RonHeg/PostAlertMailboxMFG/README.md

# PostAlertMailboxMFG
 PostAlert IoT Mailbox Unit Manufacturing documentation
