RonHeg/PostAlertMailboxMFG/Firmware Notes Mailbox.odt

Firmware Notes

RJ Hegler Technologies, LLC

Project: PostAlert Mailbox

Development Platform: STM32CubeIDE 1.15.1

Processor: STM32C011F6P

PC: Main

Path: C:\Users\Ron\STM32CubeIDE\workspace_1.15.1\STM32C0116_LoRa_Mailbox

Main.c:

/* USER CODE BEGIN Header */

/**

******************************************************************************

* @file : main.c

* @brief : Main program body

******************************************************************************

* @attention

*

* Portions (initialization) Copyright (c) 2024 STMicroelectronics.

* All rights reserved.

*

* This software is licensed under terms that can be found in the LICENSE file

* in the root directory of this software component.

* If no LICENSE file comes with this software, it is provided AS-IS.

*

* USER Code Copyright (c) 2024 RJ Hegler Technologies, LLC

******************************************************************************

*/

/* USER CODE END Header */

/* Includes ------------------------------------------------------------------*/

#include "main.h"

#include "adc.h"

#include "spi.h"

#include "gpio.h"

/* Private includes ----------------------------------------------------------*/

/* USER CODE BEGIN Includes */

#include "LoRa.h"

#include "string.h"

#include "stdio.h"

/* USER CODE END Includes */

/* Private typedef -----------------------------------------------------------*/

/* USER CODE BEGIN PTD */

/* USER CODE END PTD */

/* Private define ------------------------------------------------------------*/

/* USER CODE BEGIN PD */

/* USER CODE END PD */

/* Private macro -------------------------------------------------------------*/

/* USER CODE BEGIN PM */

/* USER CODE END PM */

/* Private variables ---------------------------------------------------------*/

/* USER CODE BEGIN PV */

LoRa myLoRa;

uint16_t LoRa_stat = 0;

uint8_t RxBuffer[20];

uint8_t txpacket[25];

char indata[18];

char TxBuffer[20];

char RxPacket[18];

char BatVolt[12];

uint32_t uid[3];

volatile int tiltBtnISR = 0;

volatile int pairBtnISR = 0;

// Magic numbers for 32-bit hashing. Copied from Murmur3.

static const uint32_t c1 = 0xcc9e2d51;

static const uint32_t c2 = 0x1b873593;

uint8_t mailBoxID[12];

char mbid[11];

uint32_t value_adc;

uint32_t batteryLevel;

char msg[4];

char cw[34] = "(c)2024 RJHegler Technologies, LLC";

char cx[5] = "V1.0";

/* USER CODE END PV */

/* Private function prototypes -----------------------------------------------*/

void SystemClock_Config(void);

/* USER CODE BEGIN PFP */

/* USER CODE END PFP */

/* Private user code ---------------------------------------------------------*/

/* USER CODE BEGIN 0 */

static uint32_t UNALIGNED_LOAD32(const char *p) {

uint32_t result;

memcpy(&result, p, sizeof(result));

return result;

}

static uint32_t Fetch32(const char *p) {

return UNALIGNED_LOAD32(p);

}

static uint32_t Rotate32(uint32_t val, int shift) {

// Avoid shifting by 32: doing so yields an undefined result.

return shift == 0 ? val : ((val >> shift) | (val << (32 - shift)));

}

// A 32-bit to 32-bit integer hash copied from Murmur3.

static uint32_t fmix(uint32_t h)

{

h ^= h >> 16;

h *= 0x85ebca6b;

h ^= h >> 13;

h *= 0xc2b2ae35;

h ^= h >> 16;

return h;

}

static uint32_t Mur(uint32_t a, uint32_t h) {

// Helper from Murmur3 for combining two 32-bit values.

a *= c1;

a = Rotate32(a, 17);

a *= c2;

h ^= a;

h = Rotate32(h, 19);

return h * 5 + 0xe6546b64;

}

// Generate UID value from uidstr[]

uint32_t Hash32Len5to12(const char *s, size_t len) {

uint32_t a = (uint32_t)len, b = a * 5, c = 9, d = b;

a += Fetch32(s);

b += Fetch32(s + len - 4);

c += Fetch32(s + ((len >> 1) & 4));

return fmix(Mur(c, Mur(b, Mur(a, d))));

}

uint32_t map(uint32_t au32_IN, uint32_t au32_INmin, uint32_t au32_INmax, uint32_t au32_OUTmin, uint32_t au32_OUTmax)

{

return ((((au32_IN - au32_INmin)*(au32_OUTmax - au32_OUTmin))/(au32_INmax - au32_INmin)) + au32_OUTmin);

}

void getBattery(void){

uint32_t voltage;

// get ADC value

HAL_ADC_Start(&hadc1);

HAL_ADC_PollForConversion(&hadc1, HAL_MAX_DELAY);

voltage = HAL_ADC_GetValue(&hadc1);

// sprintf(msg, "%lu", voltage);

// float volt = (voltage) * 0.00481;

// uint16_t volts = volt * 100;

// sprintf(msg, "%hu", volts);

if(voltage < 540){voltage = 540;}

if(voltage > 1034){voltage = 1034;}

batteryLevel = map(voltage, 540, 1034, 0, 100);

sprintf(msg, "%lu", batteryLevel);

}

/* USER CODE END 0 */

/**

* @brief The application entry point.

* @retval int

*/

int main(void)

{

/* USER CODE BEGIN 1 */

/* USER CODE END 1 */

/* MCU Configuration--------------------------------------------------------*/

/* Reset of all peripherals, Initializes the Flash interface and the Systick. */

HAL_Init();

/* USER CODE BEGIN Init */

/* USER CODE END Init */

/* Configure the system clock */

SystemClock_Config();

/* USER CODE BEGIN SysInit */

/* USER CODE END SysInit */

/* Initialize all configured peripherals */

MX_GPIO_Init();

MX_SPI1_Init();

MX_ADC1_Init();

/* USER CODE BEGIN 2 */

HAL_GPIO_WritePin (GPIOB, GPIO_PIN_7, GPIO_PIN_SET); //PWR_EN -> enable power supply

myLoRa = newLoRa();

myLoRa.CS_port = LORA_NSS_GPIO_Port;

myLoRa.CS_pin = LORA_NSS_Pin;

myLoRa.reset_port = RST_GPIO_Port;

myLoRa.reset_pin = RST_Pin;

myLoRa.DIO0_port = DIO0_GPIO_Port;

myLoRa.DIO0_pin = DIO0_Pin;

myLoRa.hSPIx = &hspi1;

myLoRa.frequency = 915; // default = 433 MHz

myLoRa.spredingFactor = SF_8; // default = SF_7

myLoRa.bandWidth = BW_125KHz; // default = BW_125KHz

myLoRa.crcRate = CR_4_5; // default = CR_4_5

myLoRa.power = POWER_11db; // default = 20db

myLoRa.overCurrentProtection = 100; // default = 100 mA

myLoRa.preamble = 8; // default = 8;

HAL_Delay(2000);

// SX1276 compatible module connected to SPI1, NSS pin connected to GPIO with label LORA_NSS

//uint8_t res = lora_init(&myLoRa, &hspi1, LORA_NSS_GPIO_Port, LORA_NSS_Pin, LORA_BASE_FREQUENCY_US);

if(LoRa_init(&myLoRa)==LORA_OK){

LoRa_stat = 1;

}

//Receiver side

LoRa_startReceiving(&myLoRa);

//uuid code:

char uidstr[25];

char uidstr1[7];

char uidstr2[9];

char uidstr3[9];

uint32_t uid;

// Arrange 12 bytes of UID into uidstr[]

uid = HAL_GetUIDw0();

sprintf(uidstr1, "%lu", uid);

// memcpy (&uidstr[8], &uid, 4);

uid = HAL_GetUIDw1();

sprintf(uidstr2, "%lu", uid);

// memcpy (&uidstr[4], &uid, 4);

uid = HAL_GetUIDw2();

sprintf(uidstr3, "%lu", uid);

strcpy(uidstr, uidstr1);

strcat(uidstr, uidstr2);

strcat(uidstr, uidstr3);

uid = Hash32Len5to12 ((const char *)uidstr, 25);

sprintf(mbid, "%lu", uid);

mbid[11] = 0;

// tiltBtnISR = 0; //clear isr

// pairBtnISR = 0; //clear isr

/* USER CODE END 2 */

/* Infinite loop */

/* USER CODE BEGIN WHILE */

while (1)

{

/* USER CODE END WHILE */

/* USER CODE BEGIN 3 */

HAL_Delay(500);

if(tiltBtnISR==1){

HAL_GPIO_WritePin (GPIOB, GPIO_PIN_7, GPIO_PIN_SET); //PWR_EN -> enable power supply

getBattery();

strcpy(TxBuffer, "md:");

strcat(TxBuffer, mbid);

strcat(TxBuffer, ":");

strcat(TxBuffer, msg);

memcpy(&txpacket, &TxBuffer, 20);

LoRa_transmit(&myLoRa, txpacket, sizeof(txpacket), 500);

// look for ak

LoRa_startReceiving(&myLoRa);

uint8_t ct = 0;

while (HAL_GPIO_ReadPin(GPIOA, DIO0_Pin) == 0 && ct < 10){

HAL_Delay(10);

ct++;

}

LoRa_receive(&myLoRa, RxBuffer, 20); //verify that ak received

//parse data: verify 'ak', skip ':' verify mbid match

uint8_t i=3;

uint8_t valid = 0;

if (RxBuffer[0] != 'a'){

valid = 1;

}

if (RxBuffer[1] != 'k'){

valid = 1;

}

while (RxBuffer[i] != ':'){

indata[i-3] = RxBuffer[i];

i++;

}

memcpy(&RxPacket, &RxBuffer, 18);

if (strcmp(indata, mbid) != 0){

valid = 1;

}

if(valid != 0){

HAL_Delay(100);

LoRa_transmit(&myLoRa, txpacket, sizeof(txpacket), 500); //retry

}

tiltBtnISR = 0; //clear isr

}

if(pairBtnISR==1){

HAL_GPIO_WritePin (GPIOB, GPIO_PIN_7, GPIO_PIN_SET); //PWR_EN -> enable power supply

strcpy(TxBuffer, "pr:");

strcat(TxBuffer, mbid);

strcat(TxBuffer, ":");

strcat(TxBuffer, "100");

memcpy(&txpacket, &TxBuffer, 20);

// HAL_UART_Transmit(&huart2, txpacket, 20, 1000);

LoRa_transmit(&myLoRa, txpacket, sizeof(txpacket), 500);

// LoRa_gotoMode(&myLoRa, SLEEP_MODE);

while(HAL_GPIO_ReadPin(GPIOA, PAIR_Pin) == 1){

HAL_Delay(50);

//***********************need button / door stuck added here

}

pairBtnISR = 0; //clear isr

}

/***************************************************************************

* keep power on for debugging -> remove commented out for release

*/

//************************need button / door stuck added here

HAL_Delay(50);

uint16_t ct = 0;

while (HAL_GPIO_ReadPin(GPIOA, TILT_Pin) == 1 && ct < 300){

HAL_Delay(100);

ct++;

}

if(HAL_GPIO_ReadPin(GPIOA, TILT_Pin) == 1){

//if (ct > 300){ //if door is open longer than 30 seconds

strcpy(TxBuffer, "do:");

strcat(TxBuffer, mbid);

strcat(TxBuffer, ":");

strcat(TxBuffer, msg);

memcpy(&txpacket, &TxBuffer, 20);

LoRa_transmit(&myLoRa, txpacket, sizeof(txpacket), 500);

}

tiltBtnISR = 0; //clear isr

// everything in deep sleep?

HAL_GPIO_WritePin (GPIOB, GPIO_PIN_7, GPIO_PIN_RESET); //PWR_EN -> disable power supply

}

/* USER CODE END 3 */

}

/**

* @brief System Clock Configuration

* @retval None

*/

void SystemClock_Config(void)

{

RCC_OscInitTypeDef RCC_OscInitStruct = {0};

RCC_ClkInitTypeDef RCC_ClkInitStruct = {0};

/** Initializes the RCC Oscillators according to the specified parameters

* in the RCC_OscInitTypeDef structure.

*/

RCC_OscInitStruct.OscillatorType = RCC_OSCILLATORTYPE_HSI;

RCC_OscInitStruct.HSIState = RCC_HSI_ON;

RCC_OscInitStruct.HSIDiv = RCC_HSI_DIV1;

RCC_OscInitStruct.HSICalibrationValue = RCC_HSICALIBRATION_DEFAULT;

if (HAL_RCC_OscConfig(&RCC_OscInitStruct) != HAL_OK)

{

Error_Handler();

}

/** Initializes the CPU, AHB and APB buses clocks

*/

RCC_ClkInitStruct.ClockType = RCC_CLOCKTYPE_HCLK|RCC_CLOCKTYPE_SYSCLK

|RCC_CLOCKTYPE_PCLK1;

RCC_ClkInitStruct.SYSCLKSource = RCC_SYSCLKSOURCE_HSI;

RCC_ClkInitStruct.SYSCLKDivider = RCC_SYSCLK_DIV1;

RCC_ClkInitStruct.AHBCLKDivider = RCC_HCLK_DIV1;

RCC_ClkInitStruct.APB1CLKDivider = RCC_APB1_DIV2;

if (HAL_RCC_ClockConfig(&RCC_ClkInitStruct, FLASH_LATENCY_1) != HAL_OK)

{

Error_Handler();

}

}

/* USER CODE BEGIN 4 */

// interrupt entry:

//Receiver side

void HAL_GPIO_EXTI_Falling_Callback(uint16_t GPIO_Pin){

// is irq from tilt sensor?

if(GPIO_Pin == TILT_Pin){

tiltBtnISR = 1;

}

//is irq from pair button?

if(GPIO_Pin == PAIR_Pin){

pairBtnISR = 1;

}else {

//tiltBtnISR = 0;

//pairBtnISR = 0;

__NOP();

}

}

/* USER CODE END 4 */

/**

* @brief This function is executed in case of error occurrence.

* @retval None

*/

void Error_Handler(void)

{

/* USER CODE BEGIN Error_Handler_Debug */

/* User can add his own implementation to report the HAL error return state */

__disable_irq();

while (1)

{

HAL_GPIO_WritePin (GPIOB, GPIO_PIN_7, GPIO_PIN_RESET); //PWR_EN -> disable power supply

}

/* USER CODE END Error_Handler_Debug */

}

#ifdef USE_FULL_ASSERT

/**

* @brief Reports the name of the source file and the source line number

* where the assert_param error has occurred.

* @param file: pointer to the source file name

* @param line: assert_param error line source number

* @retval None

*/

void assert_failed(uint8_t *file, uint32_t line)

{

/* USER CODE BEGIN 6 */

/* User can add his own implementation to report the file name and line number,

ex: printf("Wrong parameters value: file %s on line %d\r\n", file, line) */

/* USER CODE END 6 */

}

#endif /* USE_FULL_ASSERT */
