RonHeg/PostAlertMailboxMFG/042024MailBox Label.pdf

### PostAlert IoT Mail Box Label Drawing Number: 042024-LBL Revision 1.0

### RJ Hegler Technologies, LLC 9192 Albion Road North Royalton, Ohio 44133 RJHeglerTech@gmail.com Ron Hegler

440-478-1586

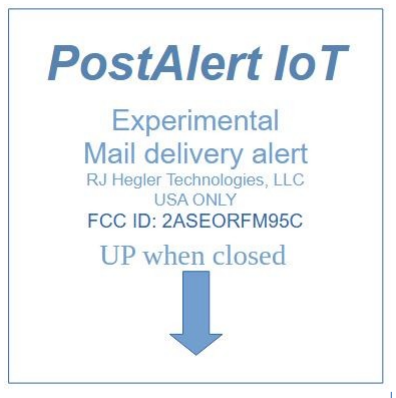
[picture p1: figure]

Overlay attaches to top of :
Hammond Manufacturing 1593JBK Enclosure

Notes:
Material: Glossy 0.2mm, PET

Adhesive backing: 3M468MP

Colors
Aqua = Pantone 319 C (RGB 44, 204, 211 – HEX 2cccd3) Black = Pantone 6C(RGB 16, 24, 32 – HEX 101803)
Gray = Pantone 5315 C (RGB 216, 215, 223 – HEX d8d7df)

Suggested Supplier:
LCSC Electronics (https://www.lcsc.com/)

# Note: Reference Drawing for

cost quoting only.

# Actual drawing will be created

when FCC ID is assigned.

2.15”

2.15”
