RonHeg/PostAlertMailboxMFG/PostAlertMailBoxV6_1.xls

Sheet: PostAlertMailBoxV6
Source: | C:\RJHTech\Mailbox\PostAlertBaseStation\PostAlertMailBoxV6\PostAlertMailBoxV6.kicad_sch
Date: | 12/10/2024 10:33:40 AM
Tool: | Eeschema 7.0.10
Generator: | C:\Program Files\KiCad\7.0\bin\scripting\plugins/bom_csv_grouped_by_value.py
Component Count: | 41
Collated Components:
Item | Qty | Reference(s) | Value | Datasheet | Description | MFR | PN | Price(100s) | Supplier | Supplier_num
1 | 1 | AE1 | Antenna | https://www.ti.com/lit/an/swra416/swra416.pdf?ts=1721033543556
2 | 1 | C1 | DNP | https://www.vishay.com/docs/45199/vjcommercialseries.pdf | Multilayer Ceramic Capacitors MLCC - SMD/SMT 0603 82pF 100volts C0G 5% | Vishay / Vitramon | VJ0603A820JXBAC | 0.073 | Mouser | 77-VJ0603A820JXBAC
3 | 1 | C2 | 3.3pF | https://www.mouser.com/datasheet/2/40/C0GNP0_Dielectric-2952720.pdf | Multilayer Ceramic Capacitors MLCC - SMD/SMT 25V 3.3pF 10% | Kyocera AVX | 06033A3R3KAT2A | 0.073 | Mouser | 581-06033A3R3KAT2A
4 | 3 | C3, C8, C13 | 1uF, 16v | https://www.mouser.com/ProductDetail/TAIYO-YUDEN/MSASE168SB7105KTNA01?qs=tlsG%2FOw5FFh5ATmmYVDecQ%3D%3D | MLCC - SMD/SMT 16V 1uF X7R 0603 10 % | TAIYO YUDEN | MSASE168SB7105KTNA01 | 0.023 | Mouser | 963-MSASE168SB7105KT
5 | 4 | C4, C6, C9, C11 | 10uf 6.3v | https://www.mouser.com/ProductDetail/KYOCERA-AVX/KGM15CR50J106MT?qs=Jm2GQyTW%2Fbif%2Fz3WIqU0uQ%3D%3D | 6.3V 10uF X5R 0603 20% | KYOCERA AVX | KGM15CR50J106MT | 0.061 | Mouser | 581-06036D106MAT2A
6 | 3 | C5, C7, C10 | 0.1uF | https://www.mouser.com/ProductDetail/KYOCERA-AVX/KGM15BR71H104KT?qs=Jm2GQyTW%2FbhrbR7gNqPCtw%3D%3D | 50V .1uF X7R 0603 10% | KYOCERA AVX | KGM15BR71H104KT | 0.019 | Mouser | A581-06035C104KAT2A
7 | 4 | D1, D2, D3, D4 | 1N4148W | https://www.digikey.in/en/htmldatasheets/production/1227459/0/0/1/1n4148w | DIODE GEN PURP 75V 0.15A SOD123F | Diotec Semiconductor | 1N4148W | 0.0378 | Digikey | 4878-1N4148WCT-ND
8 | 1 | J1 | Prog | ~ | CONN HEADER VERT 5POS 2.54MM | Harwin Inc. | M20-9990546 | 0.1707 | Digikey | 952-2268-ND
9 | 2 | J2, J3 | BATT CLIP | https://www.keyelco.com/userAssets/file/M65p11.pdf | BATT CONT CLIP A/AA 1 CEL PC PIN | Keystone Electronics | 92 | 0.2657 | Digikey | 36-92-ND
10 | 1 | L1 | 14nH | 14nH | RF Inductors - SMD Chip Wire Ind 1608(0603) 14nH +/-2% | Walsin | WLCW1608Z0G14NPB | 0.085 | Mouser
11 | 1 | Q1 | MMBT3904 | https://www.onsemi.com/pdf/datasheet/pzt3904-d.pdf | TRANS NPN 40V 0.2A SOT23 | Micro Commercial Co | MMBT3904-TP | 0.0369 | Digikey | MMBT3904TPMSCT-ND
12 | 1 | R1 | 220k | https://www.mouser.com/datasheet/2/54/CRT-1649066.pdf | Thin Film Resistors - SMD CHIP RESISTOR Precision | Vishay / Dale | CRCW0603220KFKEA | 0.01 | Mouser | 71-CRCW0603-220K-E3
13 | 3 | R2, R6, R8 | 10k | https://www.mouser.com/datasheet/2/54/CRT-1649066.pdf | Thin Film Resistors - SMD CHIP RESISTOR Precision | Vishay / Dale | CRCW060310K0FKEAC | 0.01 | Mouser | 71-CRCW060310K0FKEAC
14 | 3 | R3, R4, R7 | 100k | https://www.mouser.com/datasheet/2/54/CRT-1649066.pdf | Thin Film Resistors - SMD CHIP RESISTOR Precision | Vishay / Dale | CRCW0603100KFKEE | 0.013 | Mouser | 71-CRCW0603100KFKEE
15 | 1 | SW1 | TILT | C:\RJHTech\Mailbox\Components\SW-520-BAILIN.pdf | SW-520 Roll Ball Switch | BAILIN ELECTRONICS CO.,LTD | SW-520D | 0.3591 | Amazon | SW-520D
16 | 1 | SW2 | SW_Push | https://www.mouser.com/datasheet/2/670/ts04-2586192.pdf | Tactile Switches 6 x 6 mm 7.3 mm 160 gf Black Right Angle Through Hole SPST | CUI Devices | TS04-66-73-BK-100-SMT | 0.099 | Mouser | 179-TS046673BK100SMT
23 | 1 | U1 | MAX40203AUK+T | https://datasheets.maximintegrated.com/en/ds/MAX40200.pdf | Low Current Ideal Diode | Analog Devices | MAX40203AUK+T | 0.679 | Mouser | 700-MAX40203AUK+T
24 | 1 | U2 | RFM95CW | https://www.hoperf.com/modules/lora/RFM95CW.html#apDocument | RF TXRX MODULE ISM<1GHZ WIRE ANT | Hope FR | COM-18085 | 9.95 | Sparkfun | RFM95C
25 | 1 | U3 | STM32C011F6Px | https://www.st.com/resource/en/datasheet/stm32c011f6.pdf | rm Cortex-M0+ MCU 32 Kbytes Flash 6 Kbytes RAM 48 MHz CPU 2x USART | STMicroelectronics | STM32C011F6P6 | 0.778 | Mouser | 511-STM32C011F6P6
26 | 1 | U4 | XC6210B332MR | https://www.torexsemi.com/file/xc6210/XC6210.pdf | IC REG LINEAR 3.3V 700MA SOT25 | Torex Semiconductor Ltd | XC6210B332MR-G | 0.5443 | Digikey | 893-1075-1-ND

Sheet: Mechanical
Reference | Value | Description | MFR | PN | Price(100s) | Supplier | Supplier_num | Qty | Inventory | On Order | Datasheet
 |  | Battery
 |  | Box, 2.61x2.61 | Hammond | 1593JBK | 2.45 | Mouser |  | 1 | 1 |  | https://www.mouser.com/datasheet/2/177/1593-1389796.pdf

Sheet: PostAlertMailBoxV6_2Supplier
Reference(s) | Value | Description | MFR | PN | Qty
AE1 | Antenna | PCB Etch
C1 | DNP | MLCC - SMD/SMT 0603 82pF 100volts C0G 5% | Vishay / Vitramon | VJ0603A820JXBAC | 0
C2 | 3.3pF | Multilayer Ceramic Capacitors MLCC - SMD/SMT 25V 3.3pF 10% | Kyocera AVX | 06033A3R3KAT2A | 1
C3, C8, C13 | 1uF, 16v | MLCC - SMD/SMT 16V 1uF X7R 0603 10 % | TAIYO YUDEN | MSASE168SB7105KTNA01 | 3
C4, C6, C9, C11 | 10uf 6.3v | 6.3V 10uF X5R 0603 20% | KYOCERA AVX | KGM15CR50J106MT | 4
C5, C7, C10 | 0.1uF | 50V .1uF X7R 0603 10% | KYOCERA AVX | KGM15BR71H104KT | 3
D1, D2, D3, D4 | 1N4148W | DIODE GEN PURP 75V 0.15A SOD123F | Diotec Semiconductor | 1N4148W | 4
J1 | Prog | CONN HEADER VERT 5POS 2.54MM | Harwin Inc. | M20-9990546 | 1
J2, J3 | BATT CLIP | BATT CONT CLIP A/AA 1 CEL PC PIN | Keystone Electronics | 92 | 2
L1 | 14nH | RF Inductors - SMD Chip Wire Ind 1608(0603) 14nH +/-2% | Walsin | WLCW1608Z0G14NPB | 1
Q1 | MMBT3904 | TRANS NPN 40V 0.2A SOT23 | Micro Commercial Co | MMBT3904-TP | 1
R1 | 220k | Thin Film Resistors - SMD CHIP RESISTOR Precision | Vishay / Dale | CRCW0603220KFKEA | 1
R2, R6, R8 | 10k | Resistor 0603 10k | Vishay / Dale | CRCW060310K0FKEAC | 3
R3, R4, R7 | 100k | Resistor 0603 100k | Vishay / Dale | CRCW0603100KFKEAC | 3
SW1 | TILT | SW-520 Roll Ball Switch | BAILIN ELECTRONICS | SW-520D | 1
SW2 | SW_Push | Tactile Switches 6 x 6 mm 7.3 mm 160 gf SPST SMT | CUI Devices | TS04-66-73-BK-100-SMT | 1
U1 | MAX40203AUK+T | Low Current Ideal Diode | Analog Devices | MAX40203AUK+T
U2 | RFM95CW | RF TXRX MODULE ISM<1GHZ WIRE ANT | Hope FR | COM-18085 | 1
U3 | STM32C011F6Px | Cortex-M0+ MCU 32 K Flash 6 K RAM 48 MHz | STMicroelectronics | STM32C011F6P6 | 1
U4 | XC6210B332MR | IC REG LINEAR 3.3V 700MA SOT25 | Torex Semiconductor Ltd | XC6210B332MR-G | 1
 | Battery | Battery, Li 3.6v, AA Primary | Rammway | ER14505 | 1
 | Enclosure | Box, 2.61x2.61 | Hammond | 1593JBK | 1
