RonHeg/PostAlertMailboxMFG/(list of files, cad)

Other CAD files:
042024ASSY.dxf
