RonHeg/PostAlertMailboxMFG/042024ASSY.pdf

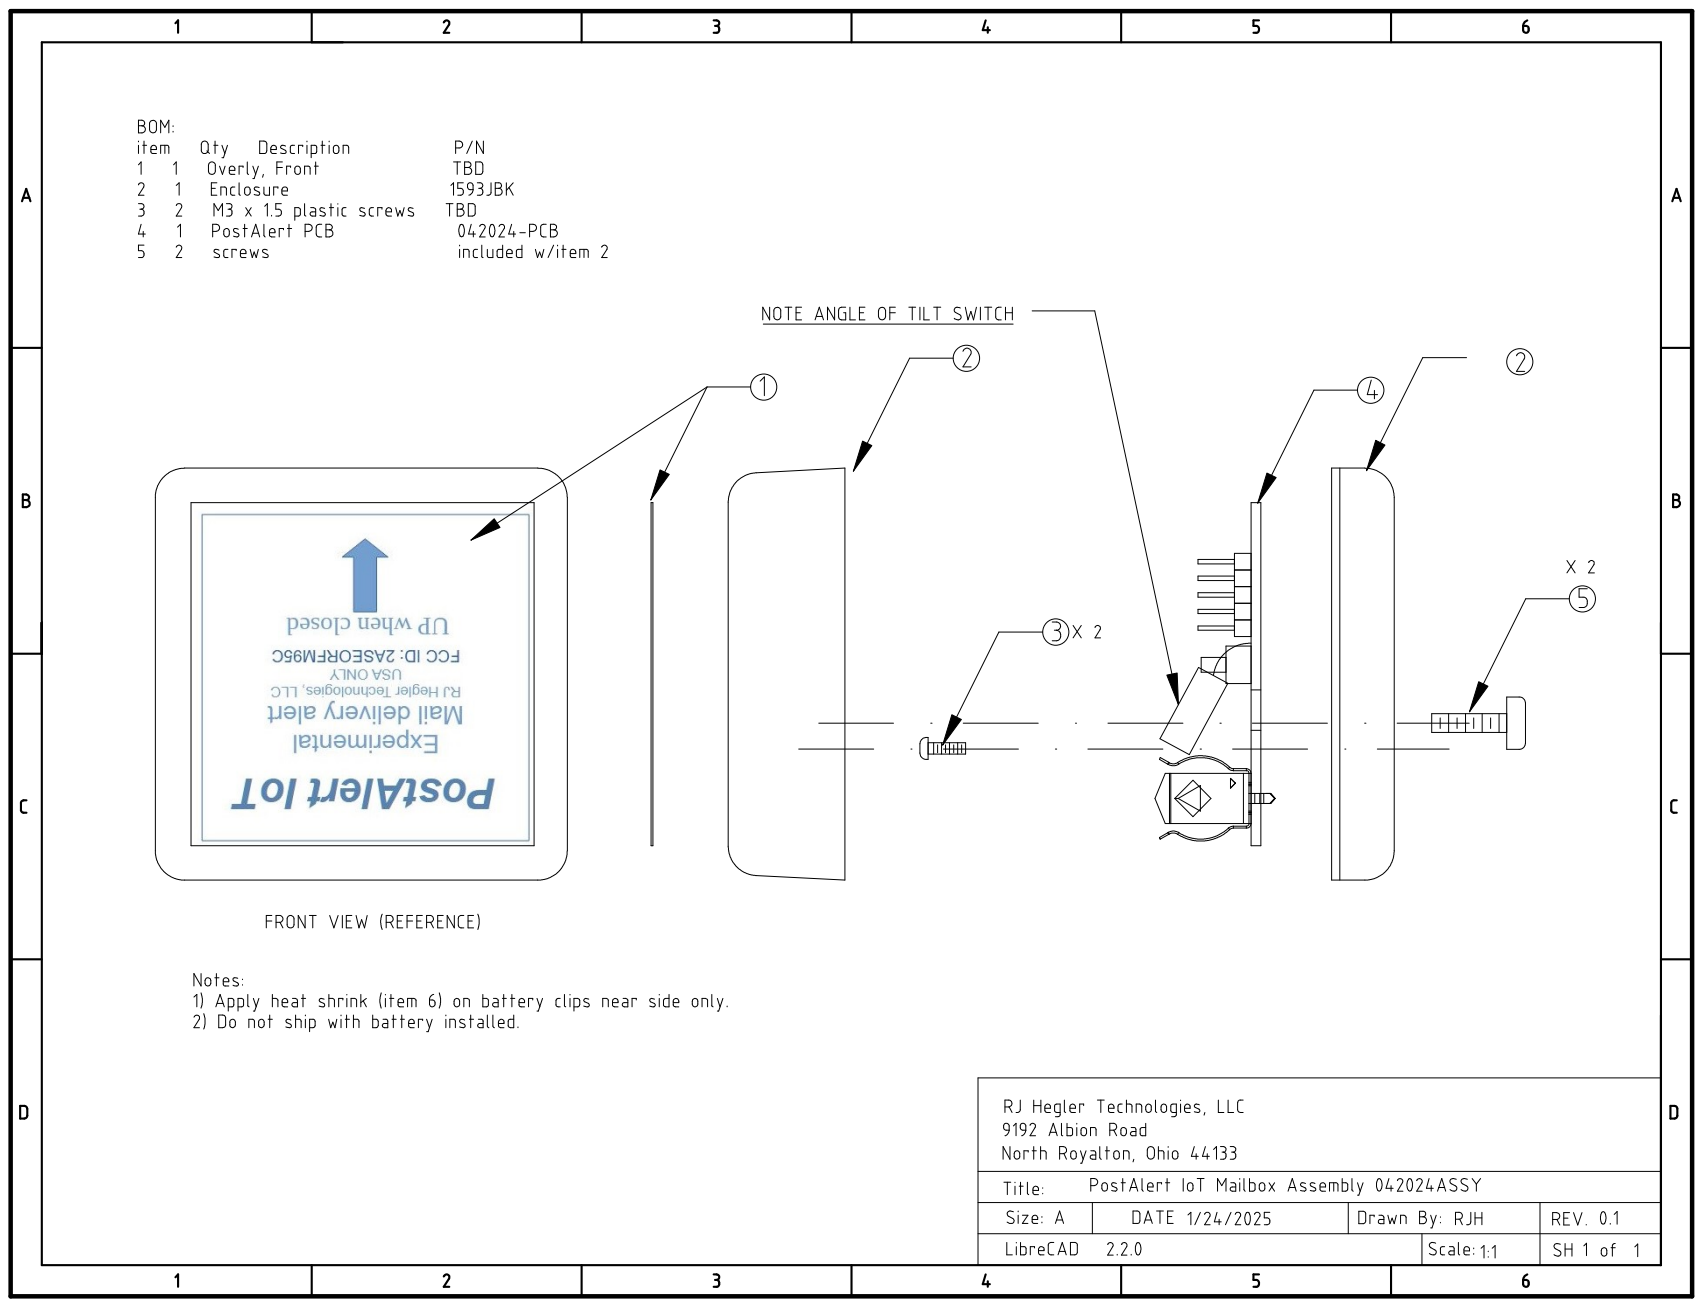
[picture p2: page 1]
