RonHeg/PostAlertMailboxMFG/PostAlert_Mailbox_PCB_Fab_Dwg.pdf

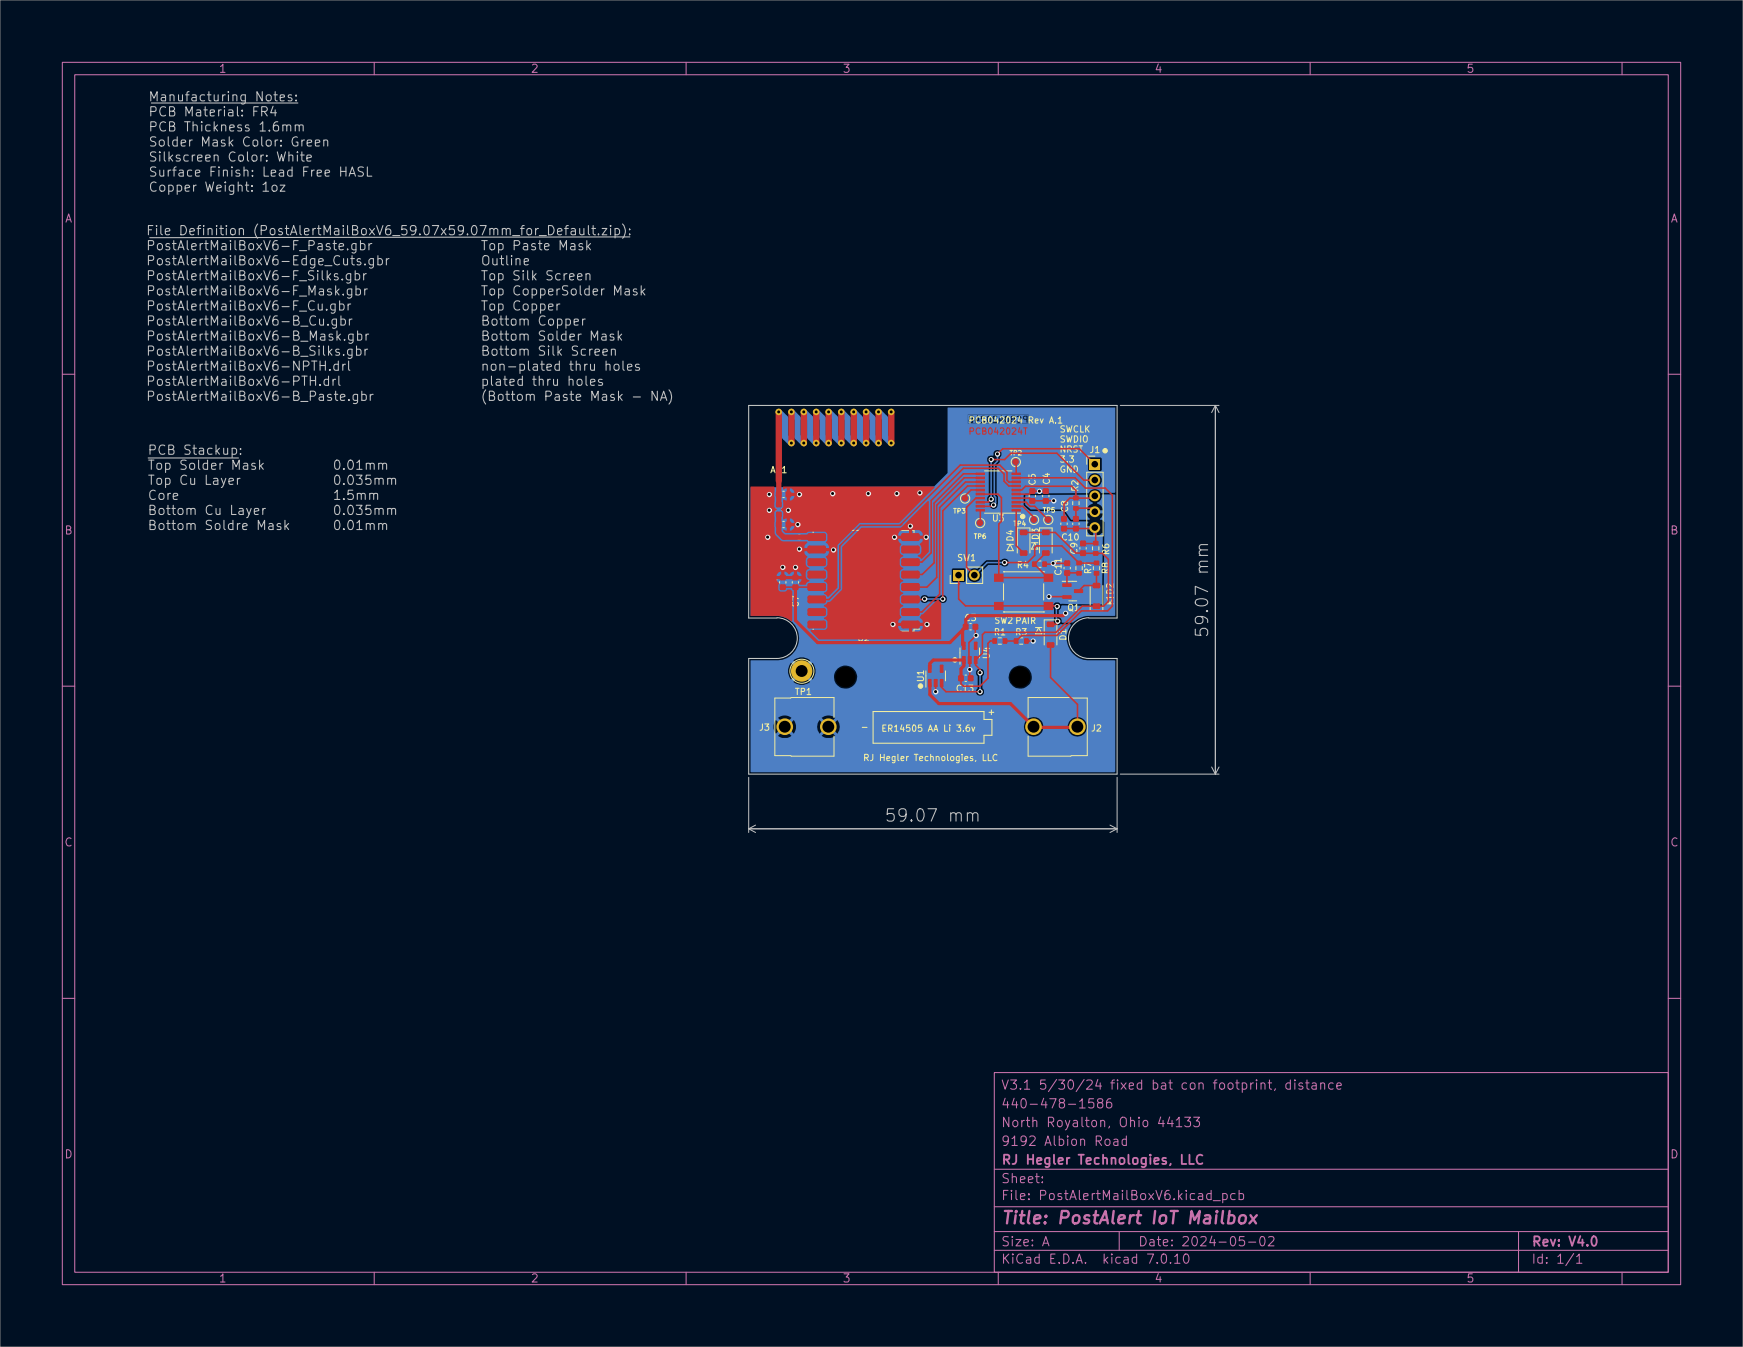
[picture p3: page 1]
