RonHeg/PostAlertMailboxMFG/KiCad/PostAlertMailBoxV6.kicad_pcb

## KiCad design KiCad/PostAlertMailBoxV6.kicad_pcb (2025-02-27)

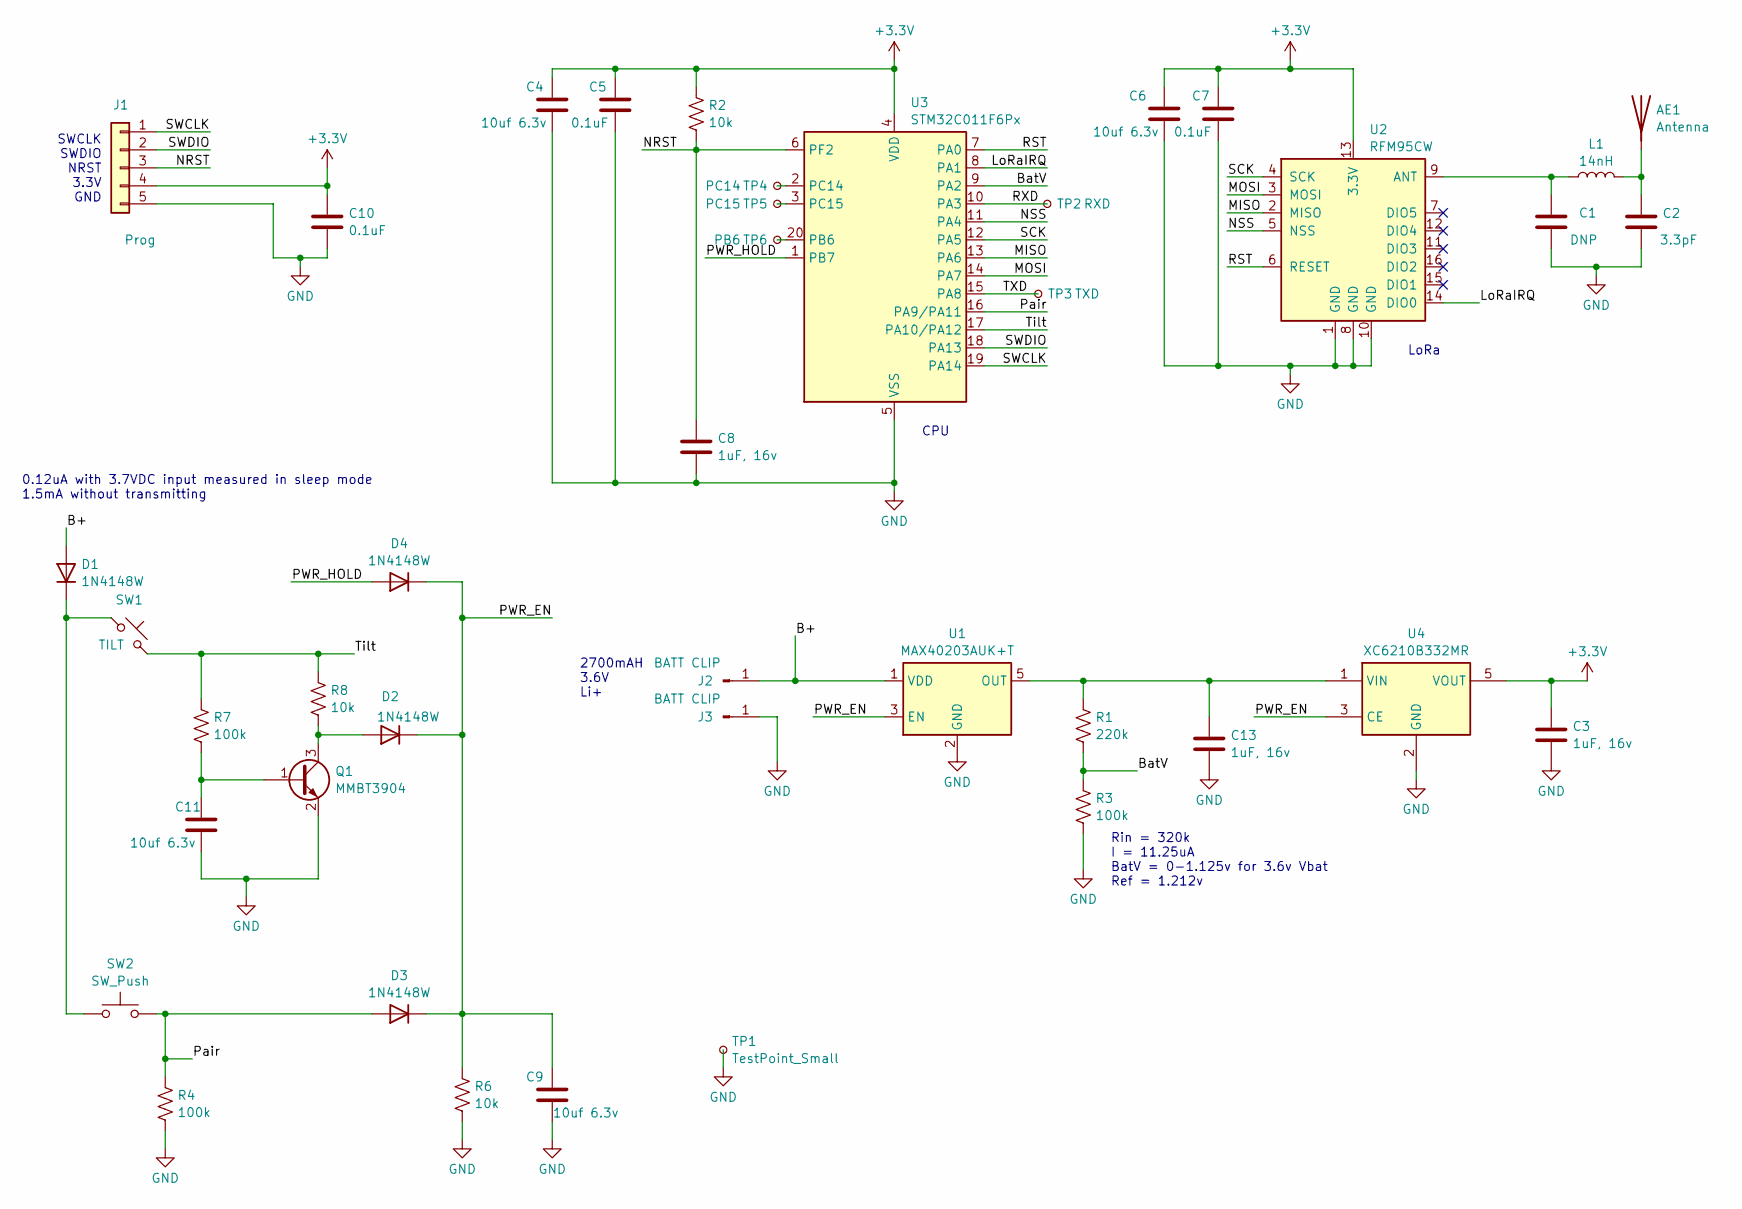
[picture p4: schematic PostAlertMailBoxV6.kicad_sch, Post Alert Mailbox V6]

Parts:
AE1: Antenna; Texas_SWRA416_868MHz_915MHz
C1: DNP; C_0603_1608Metric
C2: 3.3pF; C_0603_1608Metric
C3, C8, C13: 1uF, 16v; C_0603_1608Metric
C4, C6, C9, C11: 10uf 6.3v; C_0603_1608Metric
C5, C7, C10: 0.1uF; C_0603_1608Metric
D1, D2, D3, D4: 1N4148W; D_SOD-123
J1: Prog; PinHeader_1x05_P2.54mm_Vertical
J2, J3: BATT CLIP; BatteryClip_Keystone_92_AA-14mm
L1: 14nH; L_0603_1608Metric
Q1: MMBT3904; SOT-23
R1: 220k; R_0603_1608Metric
R2, R6, R8: 10k; R_0603_1608Metric
R3, R4, R7: 100k; R_0603_1608Metric
SW1: TILT; PinHeader_1x02_P2.54mm_Vertical
SW2: SW_Push; SW_Push_1P1T_NO_6x6mm_H9.5mm
TP1: TestPoint_Small; TestPoint_Loop_D2.50mm_Drill1.85mm
TP2: RXD; TestPoint_Pad_D1.0mm
TP3: TXD; TestPoint_Pad_D1.0mm
TP4: PC14; TestPoint_Pad_D1.0mm
TP5: PC15; TestPoint_Pad_D1.0mm
TP6: PB6; TestPoint_Pad_D1.0mm
U1: MAX40203AUK+T; SOT-23-5
U2: RFM95CW; HOPERF_RFM9XW_SMD
U3: STM32C011F6Px; TSSOP-20_4.4x6.5mm_P0.65mm
U4: XC6210B332MR; SOT-23-5

Connections:
+3.3V: C3.1, C4.1, C5.1, C6.1, C7.1, C10.1, J1.4, R2.1, U2.13 (3.3V), U3.4 (VDD), U4.5 (VOUT)
/B+: D1.2 (A), J2.1, U1.1 (VDD)
/BatV: R1.2, R3.1, U3.9 (PA2)
/LoRaIRQ: U2.14 (DIO0), U3.8 (PA1)
/MISO: U2.2 (MISO), U3.13 (PA6)
/MOSI: U2.3 (MOSI), U3.14 (PA7)
/NRST: C8.1, J1.3, R2.2, U3.6 (PF2)
/NSS: U2.5 (NSS), U3.11 (PA4)
/PWR_EN: C9.1, D2.1 (K), D3.1 (K), D4.1 (K), R6.1, U1.3 (EN), U4.3 (CE)
/PWR_HOLD: D4.2 (A), U3.1 (PB7)
/Pair: D3.2 (A), R4.1, SW2.1, U3.16 (PA9/PA11)
/RST: U2.6 (RESET), U3.7 (PA0)
/RXD: TP2.1, U3.10 (PA3)
/SCK: U2.4 (SCK), U3.12 (PA5)
/SWCLK: J1.1, U3.19 (PA14)
/SWDIO: J1.2, U3.18 (PA13)
/TXD: TP3.1, U3.15 (PA8)
/Tilt: R7.1, R8.1, SW1.2, U3.17 (PA10/PA12)
GND: C1.2, C2.2, C3.2, C4.2, C5.2, C6.2, C7.2, C8.2, C9.2, C10.2, C11.2, C13.2, J1.5, J3.1, Q1.2 (E), R3.2, R4.2, R6.2, TP1.1, U1.2 (GND), U2.1 (GND), U2.8 (GND), U2.10 (GND), U3.5 (VSS), U4.2 (GND)
unnamed: AE1.1 (A), C2.1, L1.2
unnamed: D1.1 (K), SW1.1, SW2.2
unnamed: D2.2 (A), Q1.3 (C), R8.2
unnamed: C11.1, Q1.1 (B), R7.2
unnamed: C13.1, R1.1, U1.5 (OUT), U4.1 (VIN)
unnamed: C1.1, L1.1, U2.9 (ANT)
unnamed: TP6.1, U3.20 (PB6)
unnamed: TP4.1, U3.2 (PC14)
unnamed: TP5.1, U3.3 (PC15)

Notes on the sheet:
SWCLK SWDIO NRST 3.3V GND
0.12uA with 3.7VDC input measured in sleep mode 1.5mA without transmitting
LoRa
2700mAH 3.6V Li+
Rin = 320k I = 11.25uA BatV = 0-1.125v for 3.6v Vbat Ref = 1.212v
CPU

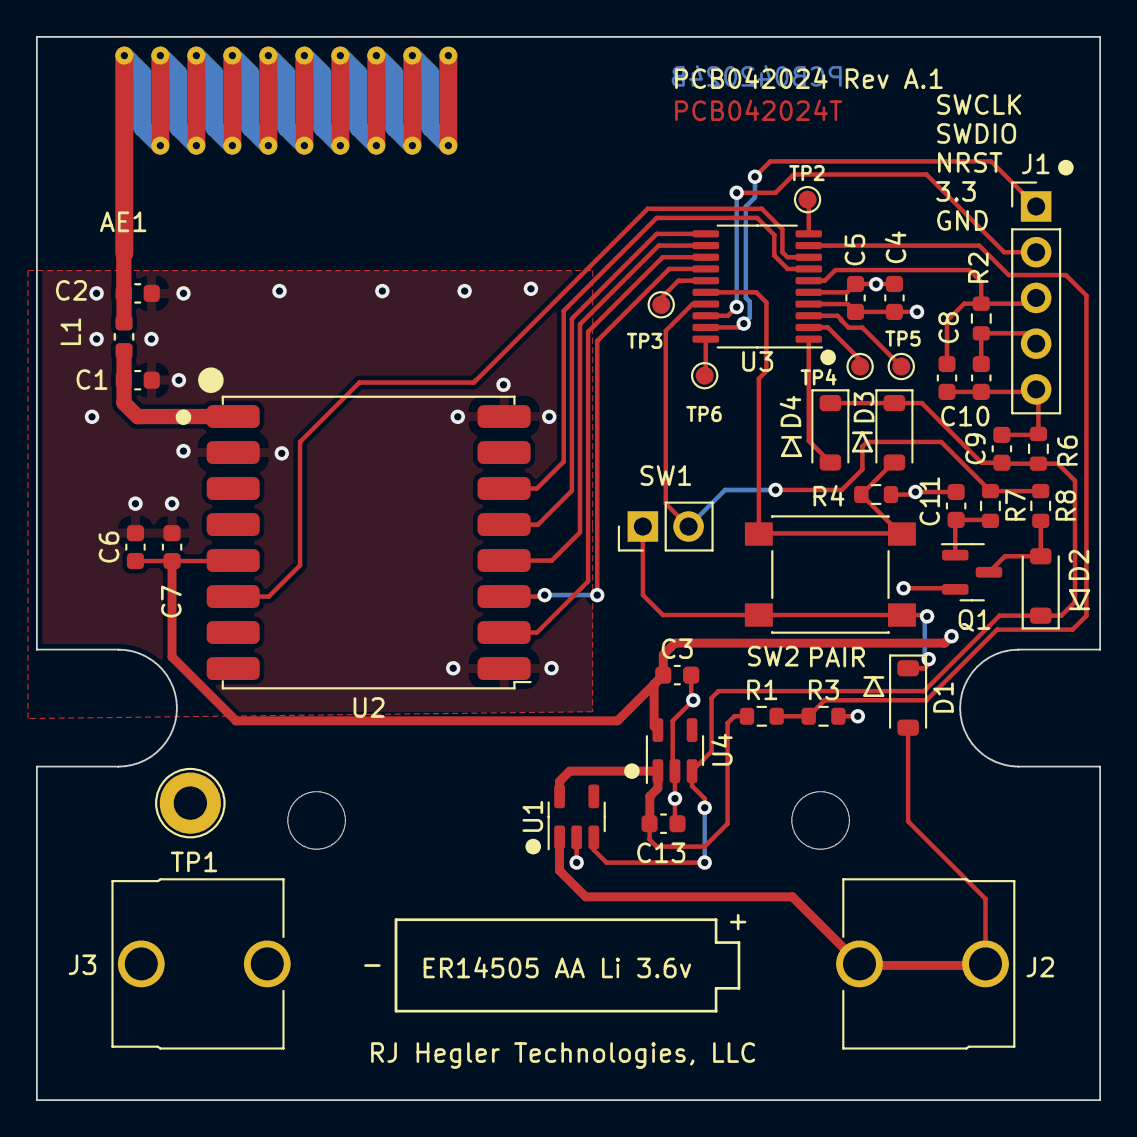
[picture p5: board PostAlertMailBoxV6.kicad_pcb from above]

Board: 2 copper layers, 59.1 x 59.1 mm, 41 parts (0 on the bottom side), 28 nets.
